PiSCSI/piscsi/hw/ctrl_board_v1p5/ctrl_board.kicad_pcb

## KiCad design hw/ctrl_board_v1p5/ctrl_board.kicad_pcb (2022-03-03, last stored version)

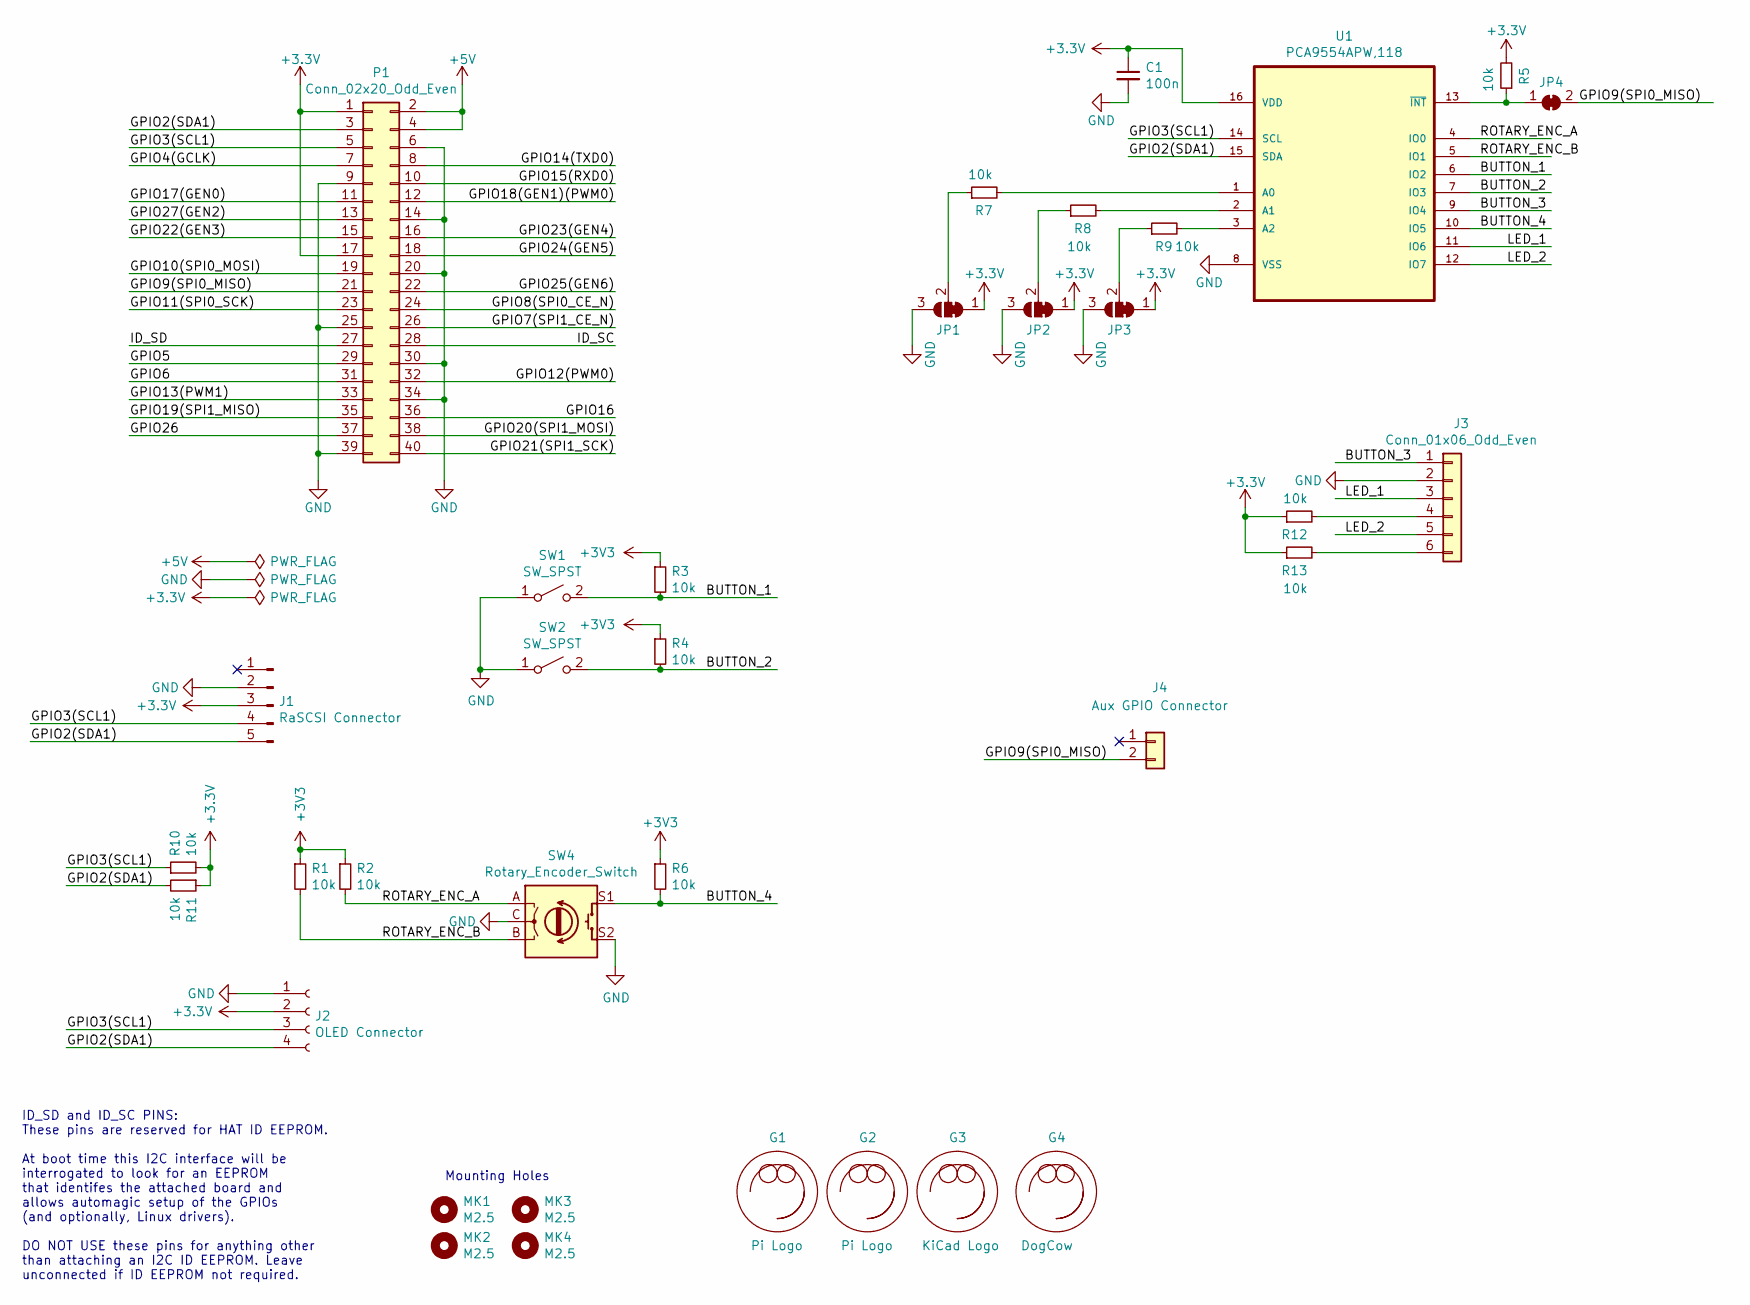
[picture p1: schematic ctrl_board.kicad_sch]

Parts:
C1: 100n; C_0805_2012Metric; LCSC C49678
G1, G2: Pi Logo; pi_logo
G3: KiCad Logo; KiCad-Logo2_5mm_SilkScreen
G4: DogCow; dogcow
J1: RaSCSI Connector; PinHeader_1x05_P2.54mm_Vertical
J2: OLED Connector; 0.9_and_1.3_in_OLED_Footprint
J3: Conn_01x06_Odd_Even; PinHeader_1x06_P2.54mm_Vertical
J4: Aux GPIO Connector; PinHeader_1x02_P2.54mm_Vertical
JP1, JP2, JP3: SolderJumper_3_Bridged12; SolderJumper-3_P1.3mm_Bridged12_RoundedPad1.0x1.5mm
JP4: SolderJumper_2_Open; SolderJumper-2_P1.3mm_Bridged_RoundedPad1.0x1.5mm
MK1, MK2, MK3, MK4: M2.5; MountingHole_2.7mm_M2.5
P1: Conn_02x20_Odd_Even; PinSocket_2x20_P2.54mm_Vertical
R1, R2, R3, R4, R5, R6, R7, R8, R9, R10, R11, R12, R13: 10k; R_0805_2012Metric; LCSC C17414
SW1, SW2: SW_SPST; SW_PUSH_6mm_H5mm; LCSC C110153
SW4: Rotary_Encoder_Switch; RotaryEncoder_Alps_EC11E-Switch_Vertical_H20mm
U1: PCA9554APW,118; TSSOP-16_4.4x5mm_P0.65mm; MPN PCA9554APW,118

Connections:
+5V: P1.2, P1.4
/BUTTON_1: R3.2, SW1.2 (B), U1.6 (IO2)
/BUTTON_2: R4.2, SW2.2 (B), U1.7 (IO3)
/BUTTON_3: J3.1, U1.9 (IO4)
/BUTTON_4: R6.2, SW4.S1, U1.10 (IO5)
/GPIO2(SDA1): J1.5, J2.4, P1.3, R11.2, U1.15 (SDA)
/GPIO3(SCL1): J1.4, J2.3, P1.5, R10.1, U1.14 (SCL)
/GPIO4(GCLK): P1.7
/GPIO5: P1.29
/GPIO6: P1.31
/GPIO7(SPI1_CE_N): P1.26
/GPIO8(SPI0_CE_N): P1.24
/GPIO9(SPI0_MISO): J4.2, JP4.2 (B), P1.21
/GPIO10(SPI0_MOSI): P1.19
/GPIO11(SPI0_SCK): P1.23
/GPIO12(PWM0): P1.32
/GPIO13(PWM1): P1.33
/GPIO14(TXD0): P1.8
/GPIO15(RXD0): P1.10
/GPIO16: P1.36
/GPIO17(GEN0): P1.11
/GPIO18(GEN1)(PWM0): P1.12
/GPIO19(SPI1_MISO): P1.35
/GPIO20(SPI1_MOSI): P1.38
/GPIO21(SPI1_SCK): P1.40
/GPIO22(GEN3): P1.15
/GPIO23(GEN4): P1.16
/GPIO24(GEN5): P1.18
/GPIO25(GEN6): P1.22
/GPIO26: P1.37
/GPIO27(GEN2): P1.13
/ID_SC: P1.28
/ID_SD: P1.27
/LED_1: J3.3, U1.11 (IO6)
/LED_2: J3.5, U1.12 (IO7)
/ROTARY_ENC_A: R2.2, SW4.A, U1.4 (IO0)
/ROTARY_ENC_B: R1.2, SW4.B, U1.5 (IO1)
GND: C1.2, J1.2, J2.1, J3.2, JP1.3 (B), JP2.3 (B), JP3.3 (B), P1.6, P1.9, P1.14, P1.20, P1.25, P1.30, P1.34, P1.39, SW1.1 (A), SW2.1 (A), SW4.C, SW4.S2, U1.8 (VSS)
unnamed: J3.4, R12.2
unnamed: J3.6, R13.2
unnamed: JP1.2 (C), R7.1
unnamed: JP2.2 (C), R8.1
unnamed: JP3.2 (C), R9.1
unnamed: JP4.1 (A), R5.1, U1.13 (~INT)
unnamed: R7.2, U1.1 (A0)
unnamed: R8.2, U1.2 (A1)
unnamed: R9.2, U1.3 (A2)

Notes on the sheet:
ID_SD and ID_SC PINS: These pins are reserved for HAT ID EEPROM. At boot time this I2C interface will be interrogated to look for an EEPROM that identifes the attached board and allows automagic setup of the GPIOs (and optionally, Linux drivers). DO NOT USE these pins for anything other than attach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
Mounting Holes

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
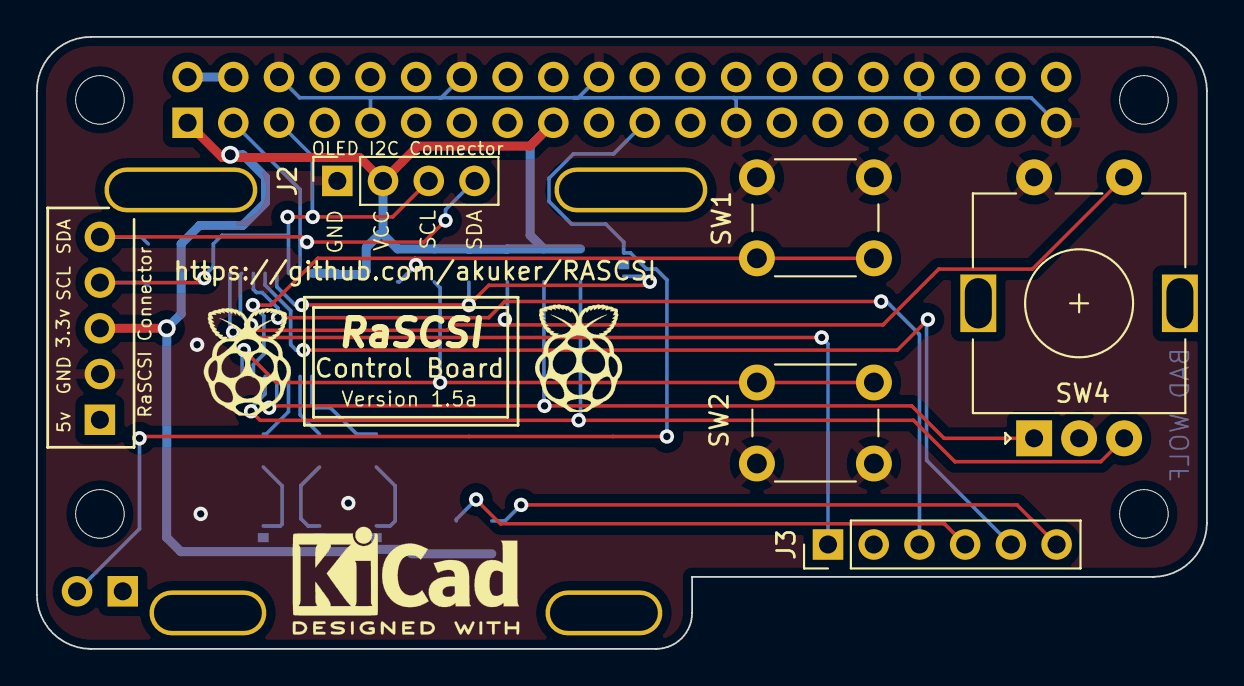
[picture p2: board ctrl_board.kicad_pcb from above]

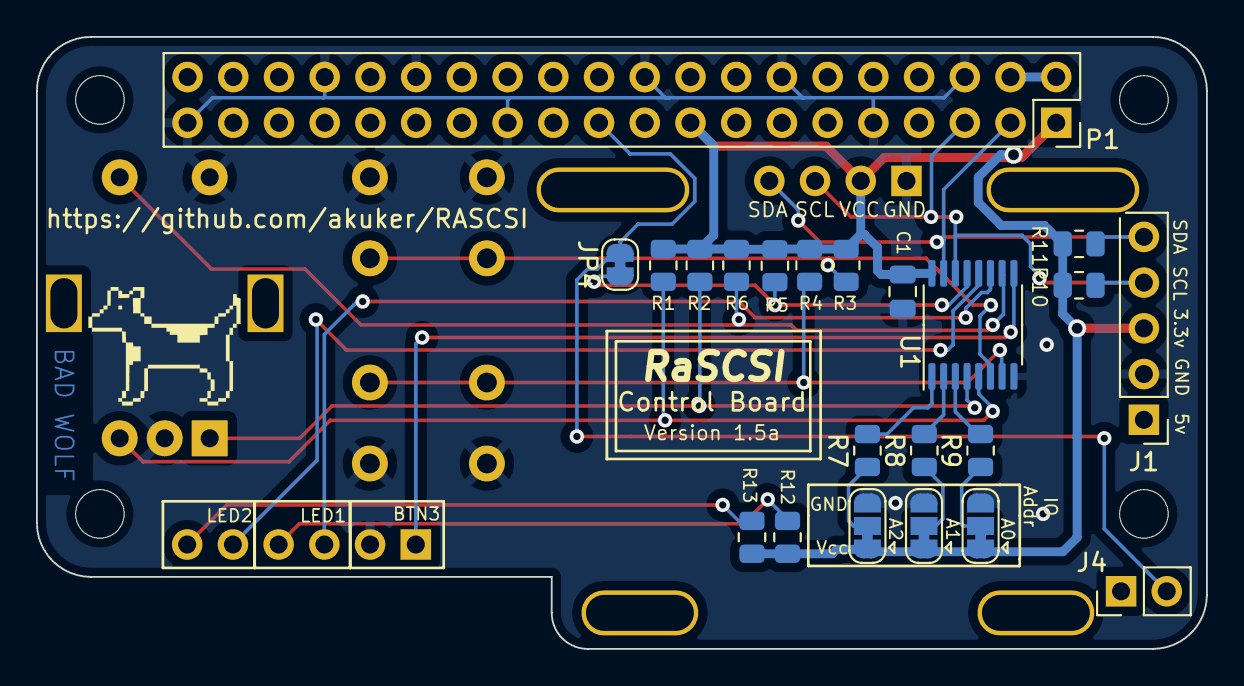
[picture p3: board ctrl_board.kicad_pcb from below]

Board: 2 copper layers, 65.0 x 34.0 mm, 35 parts (26 on the bottom side), 23 nets.
