PiSCSI/piscsi/hw/rascsi_2p5/rascsi_2p5.kicad_pcb

## KiCad design hw/rascsi_2p5/rascsi_2p5.kicad_pcb (2022-03-03, last stored version)

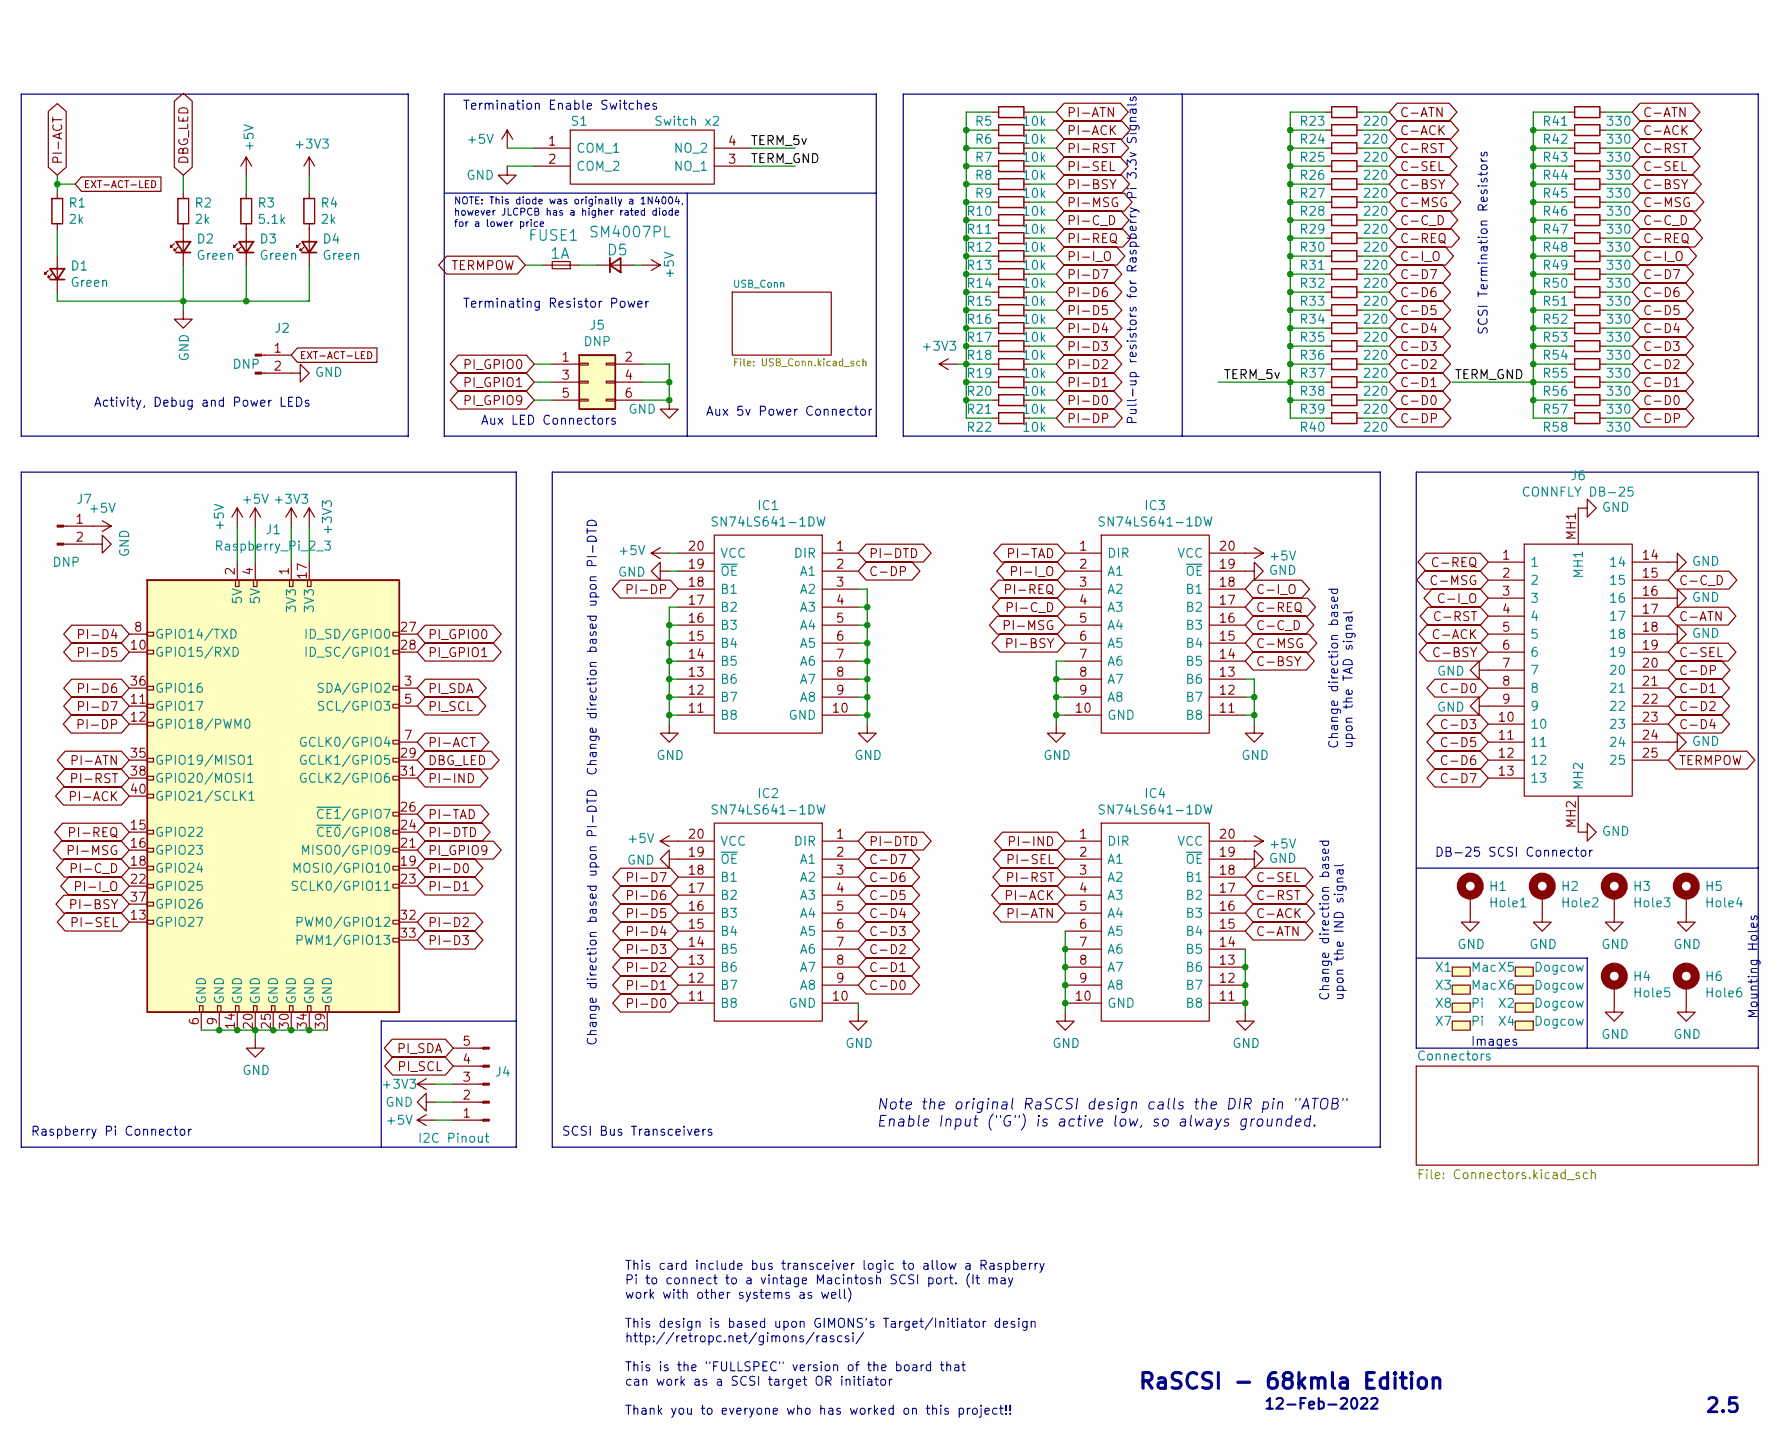
[picture p4: schematic rascsi_2p5.kicad_sch]

Parts:
D1, D2, D3, D4: Green; LED_0805_2012Metric; Manufacturer_Part_Number C2297; LCSC C2297
D5: SM4007PL; D_SOD-123F; Manufacturer_Part_Number SM4007PL; LCSC C64898
FUSE1: 1A; Fuse_1206_3216Metric; Manufacturer_Part_Number 12B1100B; LCSC C182974
H1: Hole1; MountingHole_2.7mm_M2.5_Pad_Via; Manufacturer_Part_Number DNP; LCSC DNP
H2: Hole2; MountingHole_2.7mm_M2.5_Pad_Via; Manufacturer_Part_Number DNP; LCSC DNP
H3: Hole3; MountingHole_2.7mm_M2.5_Pad_Via; Manufacturer_Part_Number DNP; LCSC DNP
H4: Hole5; MountingHole_2.7mm_M2.5_Pad_Via; Manufacturer_Part_Number DNP; LCSC DNP
H5: Hole4; MountingHole_2.7mm_M2.5_Pad_Via; Manufacturer_Part_Number DNP; LCSC DNP
H6: Hole6; MountingHole_2.7mm_M2.5_Pad_Via; Manufacturer_Part_Number DNP; LCSC DNP
IC1, IC2, IC3, IC4: SN74LS641-1DW; SOIC127P1030X265-20N; Manufacturer_Part_Number SN74LS641-1DW; LCSC N/A
J1: Raspberry_Pi_2_3; PinSocket_2x20_P2.54mm_Vertical; Manufacturer_Part_Number C50982; LCSC C50982
J2: DNP; PinHeader_1x02_P2.54mm_Horizontal; Manufacturer_Part_Number DNP; LCSC DNP
J4: I2C Pinout; PinSocket_1x05_P2.54mm_Vertical; Manufacturer_Part_Number C50950; LCSC C50950
J5: DNP; PinHeader_2x03_P2.54mm_Vertical; Manufacturer_Part_Number DNP; LCSC DNP
J6: CONNFLY DB-25; L717SDB25PA4CH4F; Manufacturer_Part_Number DS1037-25FNAKT74-0CC; LCSC C77838
J7: DNP; PinHeader_1x02_P2.54mm_Vertical; Manufacturer_Part_Number DNP; LCSC DNP
R1, R2, R4: 2k; R_0402_1005Metric; Manufacturer_Part_Number 0402WGF2001TCE; LCSC C4109
R3: 5.1k; R_0402_1005Metric; Manufacturer_Part_Number 0402WGF5101TCE; LCSC C25905
R5, R6, R7, R8, R9, R10, R11, R12, R13, R14, R15, R16, R17, R18, R19, R20, R21, R22: 10k; R_0402_1005Metric; Manufacturer_Part_Number 0402WGF1002TCE; LCSC C25744
R23, R24, R25, R26, R27, R28, R29, R30, R31, R32, R33, R34, R35, R36, R37, R38, R39, R40: 220; R_0402_1005Metric; Manufacturer_Part_Number 0402WGF2200TCE; LCSC C25091
R41, R42, R43, R44, R45, R46, R47, R48, R49, R50, R51, R52, R53, R54, R55, R56, R57, R58: 330; R_0402_1005Metric; Manufacturer_Part_Number 0402WGF3300TCE; LCSC C25104
S1: Switch x2; SOIC127P812X230-4N; Manufacturer_Part_Number DSHP02TSGET; LCSC C40735
X1, X3: Mac; mac_happy_small; Manufacturer_Part_Number N/A; LCSC N/A
X2, X4, X5, X6: Dogcow; dogcow; Manufacturer_Part_Number N/A; LCSC N/A
X7: Pi; pi_logo; Manufacturer_Part_Number N/A; LCSC N/A
X8: Pi; scsi_logo; Manufacturer_Part_Number N/A; LCSC N/A

Connections:
+3V3: J1.1 (3V3), J1.17 (3V3), J4.3, R4.1, R5.1, R6.1, R7.1, R8.1, R9.1, R10.1, R11.1, R12.1, R13.1, R14.1, R15.1, R16.1, R17.1, R18.1, R19.1, R20.1, R21.1, R22.1
+5V: D5.2 (A), IC1.20 (VCC), IC2.20 (VCC), IC3.20 (VCC), IC4.20 (VCC), J1.2 (5V), J1.4 (5V), J4.1, J7.1, R3.1, S1.1 (COM_1); also elsewhere on the board
/TERM_5v: R23.1, R24.1, R25.1, R26.1, R27.1, R28.1, R29.1, R30.1, R31.1, R32.1, R33.1, R34.1, R35.1, R36.1, R37.1, R38.1, R39.1, R40.1, S1.4 (NO_2)
/TERM_GND: R41.1, R42.1, R43.1, R44.1, R45.1, R46.1, R47.1, R48.1, R49.1, R50.1, R51.1, R52.1, R53.1, R54.1, R55.1, R56.1, R57.1, R58.1, S1.3 (NO_1)
C-ACK: IC4.16 (B3), J6.5, R24.2, R42.2; also elsewhere on the board
C-ATN: IC4.15 (B4), J6.17, R23.2, R41.2; also elsewhere on the board
C-BSY: IC3.14 (B5), J6.6, R27.2, R45.2; also elsewhere on the board
C-C_D: IC3.16 (B3), J6.15, R29.2, R47.2; also elsewhere on the board
C-D0: IC2.9 (A8), J6.8, R39.2, R57.2; also elsewhere on the board
C-D1: IC2.8 (A7), J6.21, R38.2, R56.2; also elsewhere on the board
C-D2: IC2.7 (A6), J6.22, R37.2, R55.2; also elsewhere on the board
C-D3: IC2.6 (A5), J6.10, R36.2, R54.2; also elsewhere on the board
C-D4: IC2.5 (A4), J6.23, R35.2, R53.2; also elsewhere on the board
C-D5: IC2.4 (A3), J6.11, R34.2, R52.2; also elsewhere on the board
C-D6: IC2.3 (A2), J6.12, R33.2, R51.2; also elsewhere on the board
C-D7: IC2.2 (A1), J6.13, R32.2, R50.2; also elsewhere on the board
C-DP: IC1.2 (A1), J6.20, R40.2, R58.2; also elsewhere on the board
C-I_O: IC3.18 (B1), J6.3, R31.2, R49.2; also elsewhere on the board
C-MSG: IC3.15 (B4), J6.2, R28.2, R46.2; also elsewhere on the board
C-REQ: IC3.17 (B2), J6.1, R30.2, R48.2; also elsewhere on the board
C-RST: IC4.17 (B2), J6.4, R25.2, R43.2; also elsewhere on the board
C-SEL: IC4.18 (B1), J6.19, R26.2, R44.2; also elsewhere on the board
DBG_LED: J1.29 (GCLK1/GPIO5), R2.1
GND: D1.1 (K), D2.1 (K), D3.1 (K), D4.1 (K), H1.1, H2.1, H3.1, H4.1, H5.1, H6.1, IC1.3 (A2), IC1.4 (A3), IC1.5 (A4), IC1.6 (A5), IC1.7 (A6), IC1.8 (A7), IC1.9 (A8), IC1.10 (GND), IC1.11 (B8), IC1.12 (B7), IC1.13 (B6), IC1.14 (B5), IC1.15 (B4), IC1.16 (B3), IC1.17 (B2), IC1.19 (~OE), IC2.10 (GND), IC2.19 (~OE), IC3.7 (A6), IC3.8 (A7), IC3.9 (A8), IC3.10 (GND), IC3.11 (B8), IC3.12 (B7), IC3.13 (B6), IC3.19 (~OE), IC4.6 (A5), IC4.7 (A6), IC4.8 (A7), IC4.9 (A8), IC4.10 (GND), IC4.11 (B8), IC4.12 (B7), IC4.13 (B6), IC4.14 (B5), IC4.19 (~OE), J1.6 (GND), J1.9 (GND), J1.14 (GND), J1.20 (GND), J1.25 (GND), J1.30 (GND), J1.34 (GND), J1.39 (GND), J2.2, J4.2, J5.2, J5.4, J5.6, J6.7, J6.9, J6.14, J6.16, J6.18, J6.24, J6.MH1, J6.MH2, J7.2, S1.2 (COM_2); also elsewhere on the board
unnamed: D1.2 (A), R1.2
unnamed: D2.2 (A), R2.2
unnamed: D3.2 (A), R3.2
unnamed: D4.2 (A), R4.2
unnamed: D5.1 (K), FUSE1.1
PB_LED_Pin: J1.7 (GCLK0/GPIO4), J2.1, R1.1; also elsewhere on the board
PI-ACK: IC4.4 (A3), J1.40 (GPIO21/SCLK1), R6.2
PI-ATN: IC4.5 (A4), J1.35 (GPIO19/MISO1), R5.2
PI-BSY: IC3.6 (A5), J1.37 (GPIO26), R9.2
PI-C_D: IC3.4 (A3), J1.18 (GPIO24), R11.2
PI-D0: IC2.11 (B8), J1.19 (MOSI0/GPIO10), R21.2
PI-D1: IC2.12 (B7), J1.23 (SCLK0/GPIO11), R20.2
PI-D2: IC2.13 (B6), J1.32 (PWM0/GPIO12), R19.2
PI-D3: IC2.14 (B5), J1.33 (PWM1/GPIO13), R18.2
PI-D4: IC2.15 (B4), J1.8 (GPIO14/TXD), R17.2
PI-D5: IC2.16 (B3), J1.10 (GPIO15/RXD), R16.2
PI-D6: IC2.17 (B2), J1.36 (GPIO16), R15.2
PI-D7: IC2.18 (B1), J1.11 (GPIO17), R14.2
PI-DP: IC1.18 (B1), J1.12 (GPIO18/PWM0), R22.2
PI-DTD: IC1.1 (DIR), IC2.1 (DIR), J1.24 (~CE0/GPIO8)
PI-IND: IC4.1 (DIR), J1.31 (GCLK2/GPIO6)
PI-I_O: IC3.2 (A1), J1.22 (GPIO25), R13.2
PI-MSG: IC3.5 (A4), J1.16 (GPIO23), R10.2
PI-REQ: IC3.3 (A2), J1.15 (GPIO22), R12.2
PI-RST: IC4.3 (A2), J1.38 (GPIO20/MOSI1), R7.2
PI-SEL: IC4.2 (A1), J1.13 (GPIO27), R8.2
PI-TAD: IC3.1 (DIR), J1.26 (~CE1/GPIO7)
PI_GPIO0: J1.27 (ID_SD/GPIO0), J5.1
PI_GPIO1: J1.28 (ID_SC/GPIO1), J5.3
PI_GPIO9: J1.21 (MISO0/GPIO9), J5.5
PI_SCL: J1.5 (SCL/GPIO3), J4.4
PI_SDA: J1.3 (SDA/GPIO2), J4.5
TERMPOW: FUSE1.2, J6.25; also elsewhere on the board

Notes on the sheet:
Images
RaSCSI - 68kmla Edition
2.5
Raspberry Pi Connector
Change direction based upon the TAD signal
Terminating Resistor Power
Mounting Holes
12-Feb-2022
DB-25 SCSI Connector
SCSI Termination Resistors
Pull-up resistors for Raspberry Pi 3.3v Signals
Change direction based upon the IND signal
NOTE: This diode was originally a 1N4004, however JLCPCB has a higher rated diode for a lower price
Change direction based upon PI-DTD
Note the original RaSCSI design calls the DIR pin "ATOB" Enable Input ("G") is active low, so always grounded.
Activity, Debug and Power LEDs
Termination Enable Switches
This card include bus transceiver logic to allow a Raspberry Pi to connect to a vintage Macintosh SCSI port. (It may work with other systems as well) This design is based upon GIMONS's Target/Initiator design http://retropc.net/gimons/rascsi/ This is the "FULLSPEC" version of the board that can wor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
Aux 5v Power Connector
SCSI Bus Transceivers
Aux LED Connectors

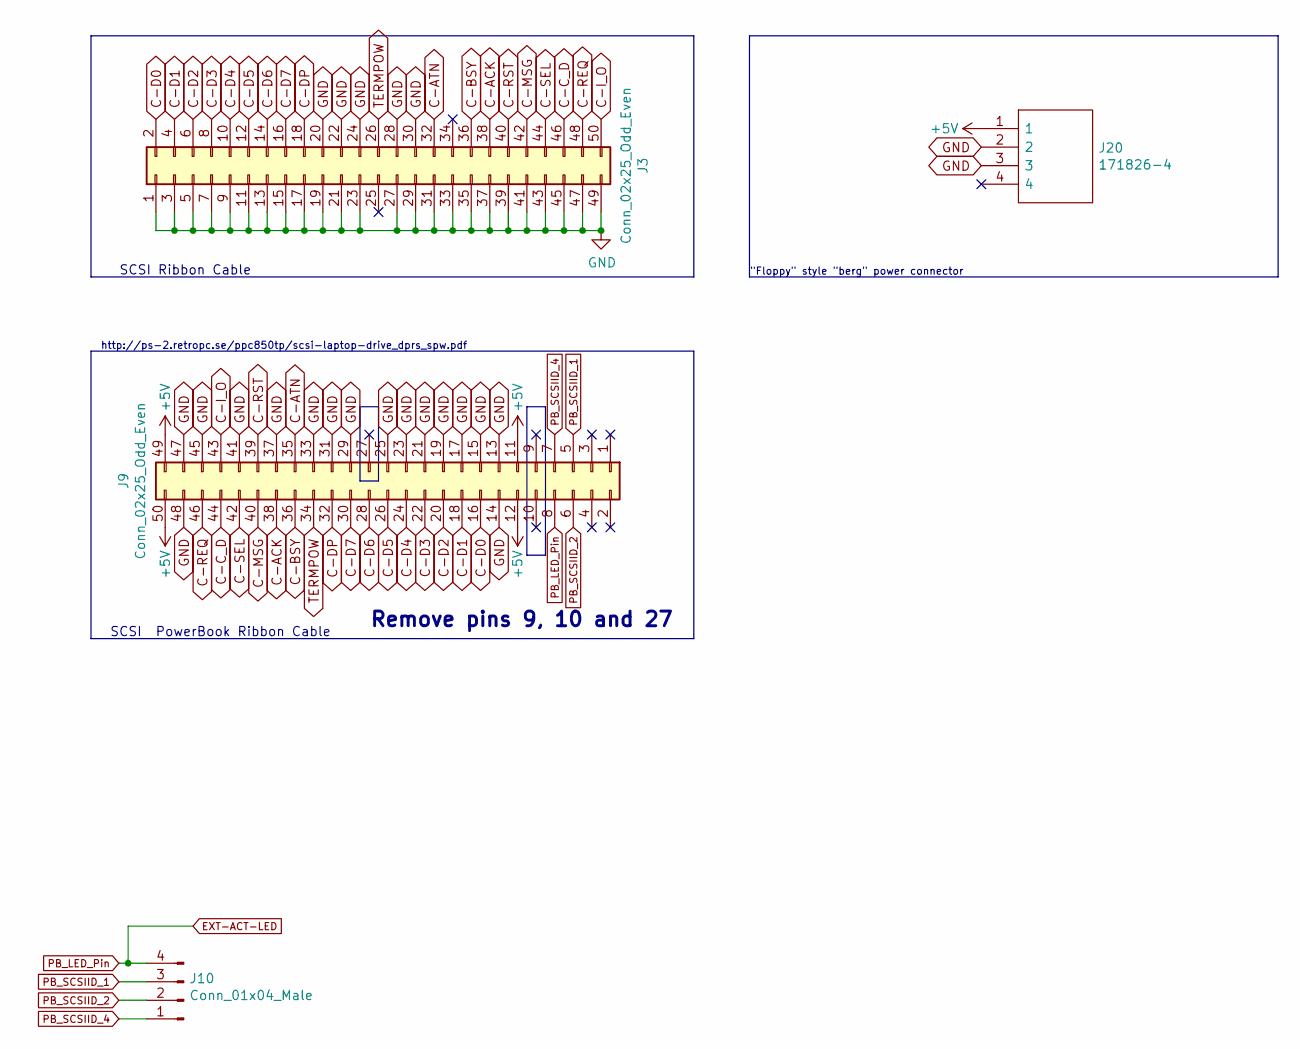
[picture p5: schematic Connectors.kicad_sch]

Parts:
J3: Conn_02x25_Odd_Even; PinHeader_2x25_P2.54mm_Vertical; Manufacturer_Part_Number C30006; LCSC C30006
J9: Conn_02x25_Odd_Even; PinHeader_2x25_P2.00mm_Horizontal; Manufacturer_Part_Number C3407; LCSC C3407
J10: Conn_01x04_Male; PinHeader_1x04_P2.00mm_Vertical
J20: 171826-4; SHDRRA4W69P0X250_1X4_1000X1350X670P; Mouser Part Number 571-1718264

Connections:
+5V: J9.11, J9.12, J9.49, J9.50, J20.1; also elsewhere on the board
C-ACK: J3.38, J9.38; also elsewhere on the board
C-ATN: J3.32, J9.35; also elsewhere on the board
C-BSY: J3.36, J9.36; also elsewhere on the board
C-C_D: J3.46, J9.44; also elsewhere on the board
C-D0: J3.2, J9.16; also elsewhere on the board
C-D1: J3.4, J9.18; also elsewhere on the board
C-D2: J3.6, J9.20; also elsewhere on the board
C-D3: J3.8, J9.22; also elsewhere on the board
C-D4: J3.10, J9.24; also elsewhere on the board
C-D5: J3.12, J9.26; also elsewhere on the board
C-D6: J3.14, J9.28; also elsewhere on the board
C-D7: J3.16, J9.30; also elsewhere on the board
C-DP: J3.18, J9.32; also elsewhere on the board
C-I_O: J3.50, J9.43; also elsewhere on the board
C-MSG: J3.42, J9.40; also elsewhere on the board
C-REQ: J3.48, J9.46; also elsewhere on the board
C-RST: J3.40, J9.39; also elsewhere on the board
C-SEL: J3.44, J9.42; also elsewhere on the board
GND: J3.1, J3.3, J3.5, J3.7, J3.9, J3.11, J3.13, J3.15, J3.17, J3.19, J3.20, J3.21, J3.22, J3.23, J3.24, J3.27, J3.28, J3.29, J3.30, J3.31, J3.33, J3.35, J3.37, J3.39, J3.41, J3.43, J3.45, J3.47, J3.49, J9.13, J9.14, J9.15, J9.17, J9.19, J9.21, J9.23, J9.25, J9.29, J9.31, J9.33, J9.37, J9.41, J9.45, J9.47, J9.48, J20.2, J20.3; also elsewhere on the board
PB_LED_Pin: J9.8, J10.4; also elsewhere on the board
PB_SCSIID_1: J9.5, J10.3
PB_SCSIID_2: J9.6, J10.2
PB_SCSIID_4: J9.7, J10.1
TERMPOW: J3.26, J9.34; also elsewhere on the board

Notes on the sheet:
Remove pins 9, 10 and 27
SCSI Ribbon Cable
"Floppy" style "berg" power connector
http://ps-2.retropc.se/ppc850tp/scsi-laptop-drive_dprs_spw.pdf
SCSI PowerBook Ribbon Cable

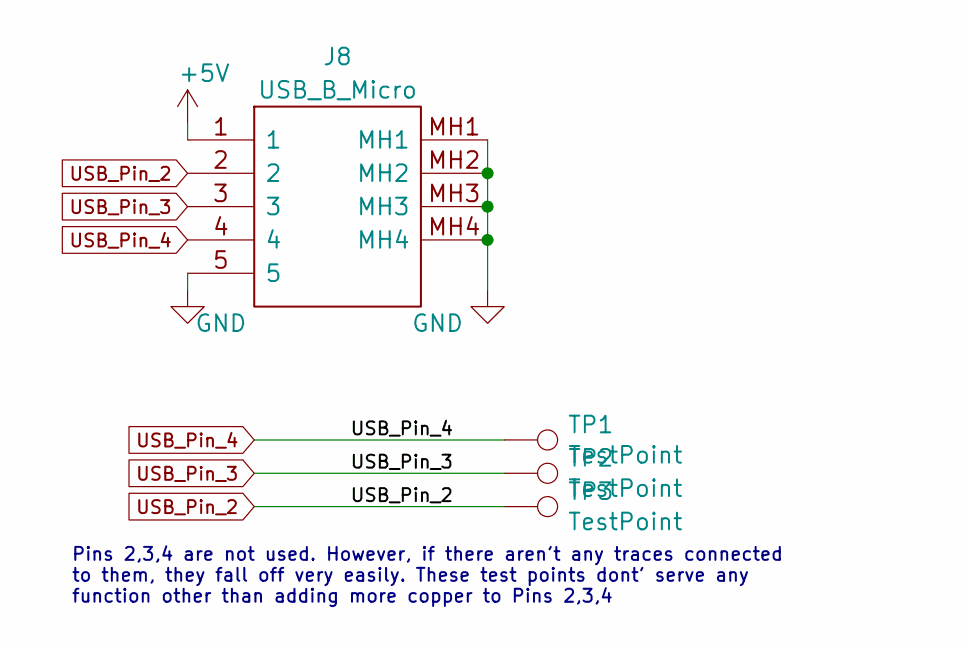
[picture p6: schematic USB_Conn.kicad_sch]

Parts:
J8: USB_B_Micro; U254051N4BH806; Manufacturer_Part_Number U254-051N-4BH806; LCSC C319170
TP1, TP2, TP3: TestPoint; TestPoint_Pad_D1.0mm; Manufacturer_Part_Number N/A; LCSC N/A

Connections:
+5V: J8.1; also elsewhere on the board
GND: J8.5, J8.MH1, J8.MH2, J8.MH3, J8.MH4; also elsewhere on the board
USB_Pin_2: J8.2, TP3.1
USB_Pin_3: J8.3, TP2.1
USB_Pin_4: J8.4, TP1.1

Notes on the sheet:
Pins 2,3,4 are not used. However, if there aren't any traces connected to them, they fall off very easily. These test points dont' serve any function other than adding more copper to Pins 2,3,4

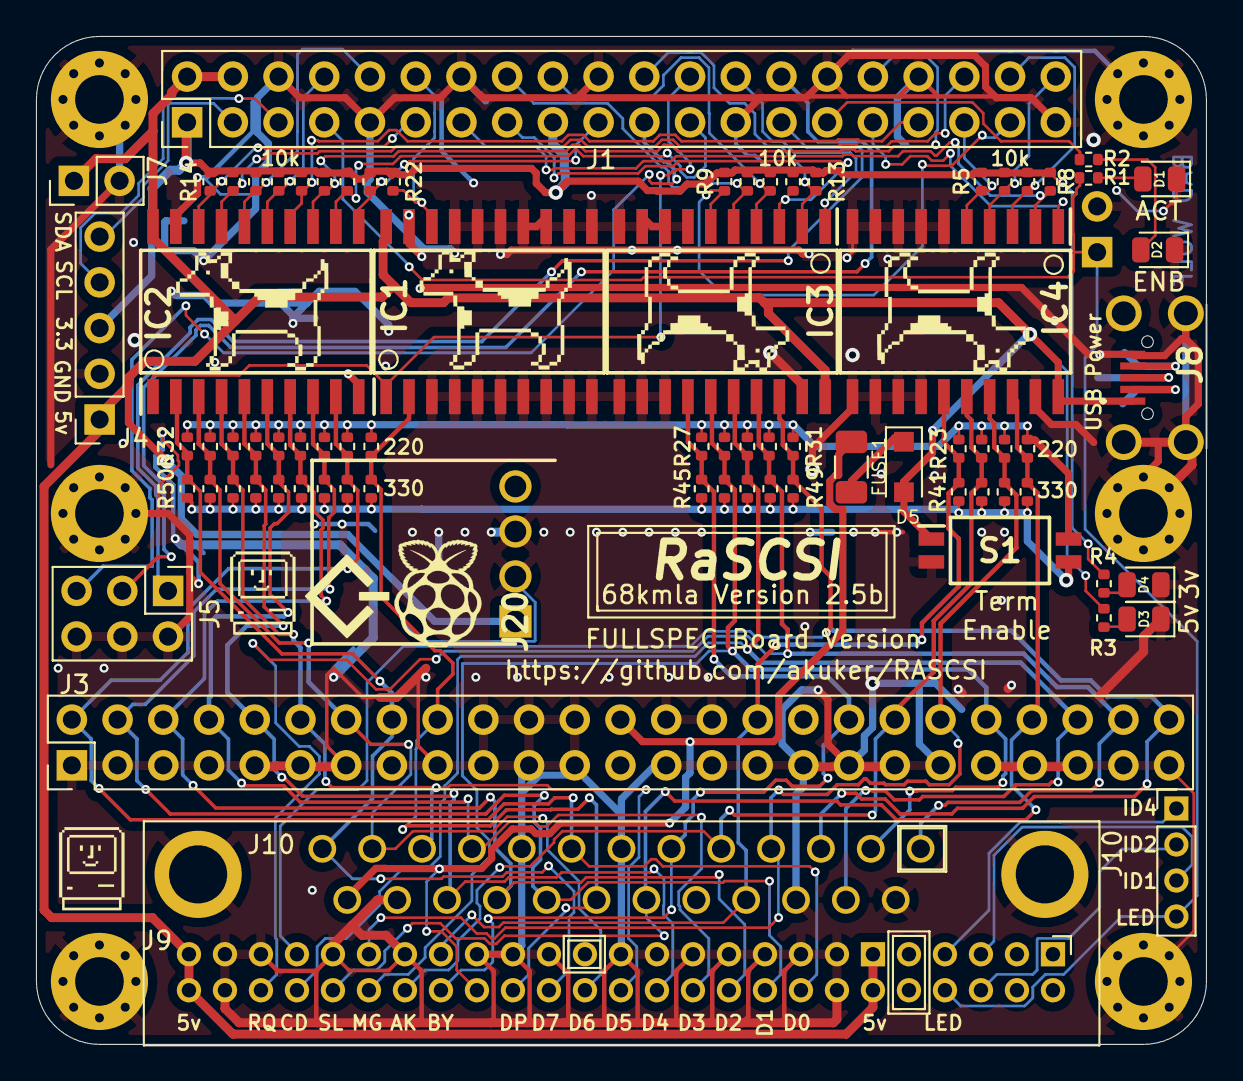
[picture p7: board rascsi_2p5.kicad_pcb from above]

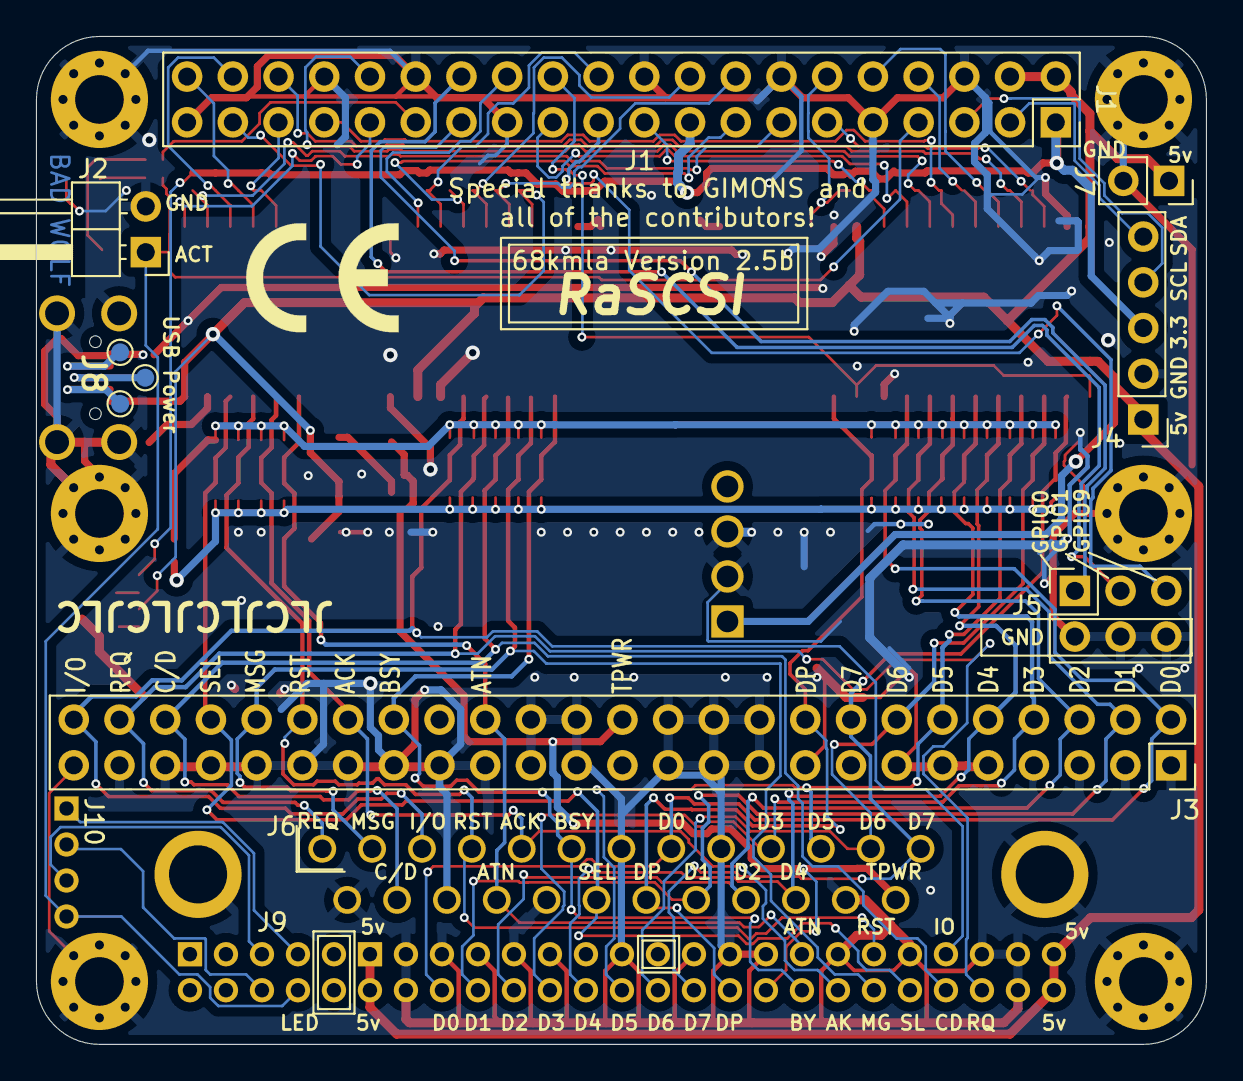
[picture p8: board rascsi_2p5.kicad_pcb from below]

Board: 2 copper layers, 65.0 x 56.0 mm, 97 parts (6 on the bottom side), 63 nets.
