PiSCSI/piscsi/hw/rascsi_tester/rascsi_tester.kicad_pcb

## KiCad design hw/rascsi_tester/rascsi_tester.kicad_pcb (2020-08-23, last stored version)

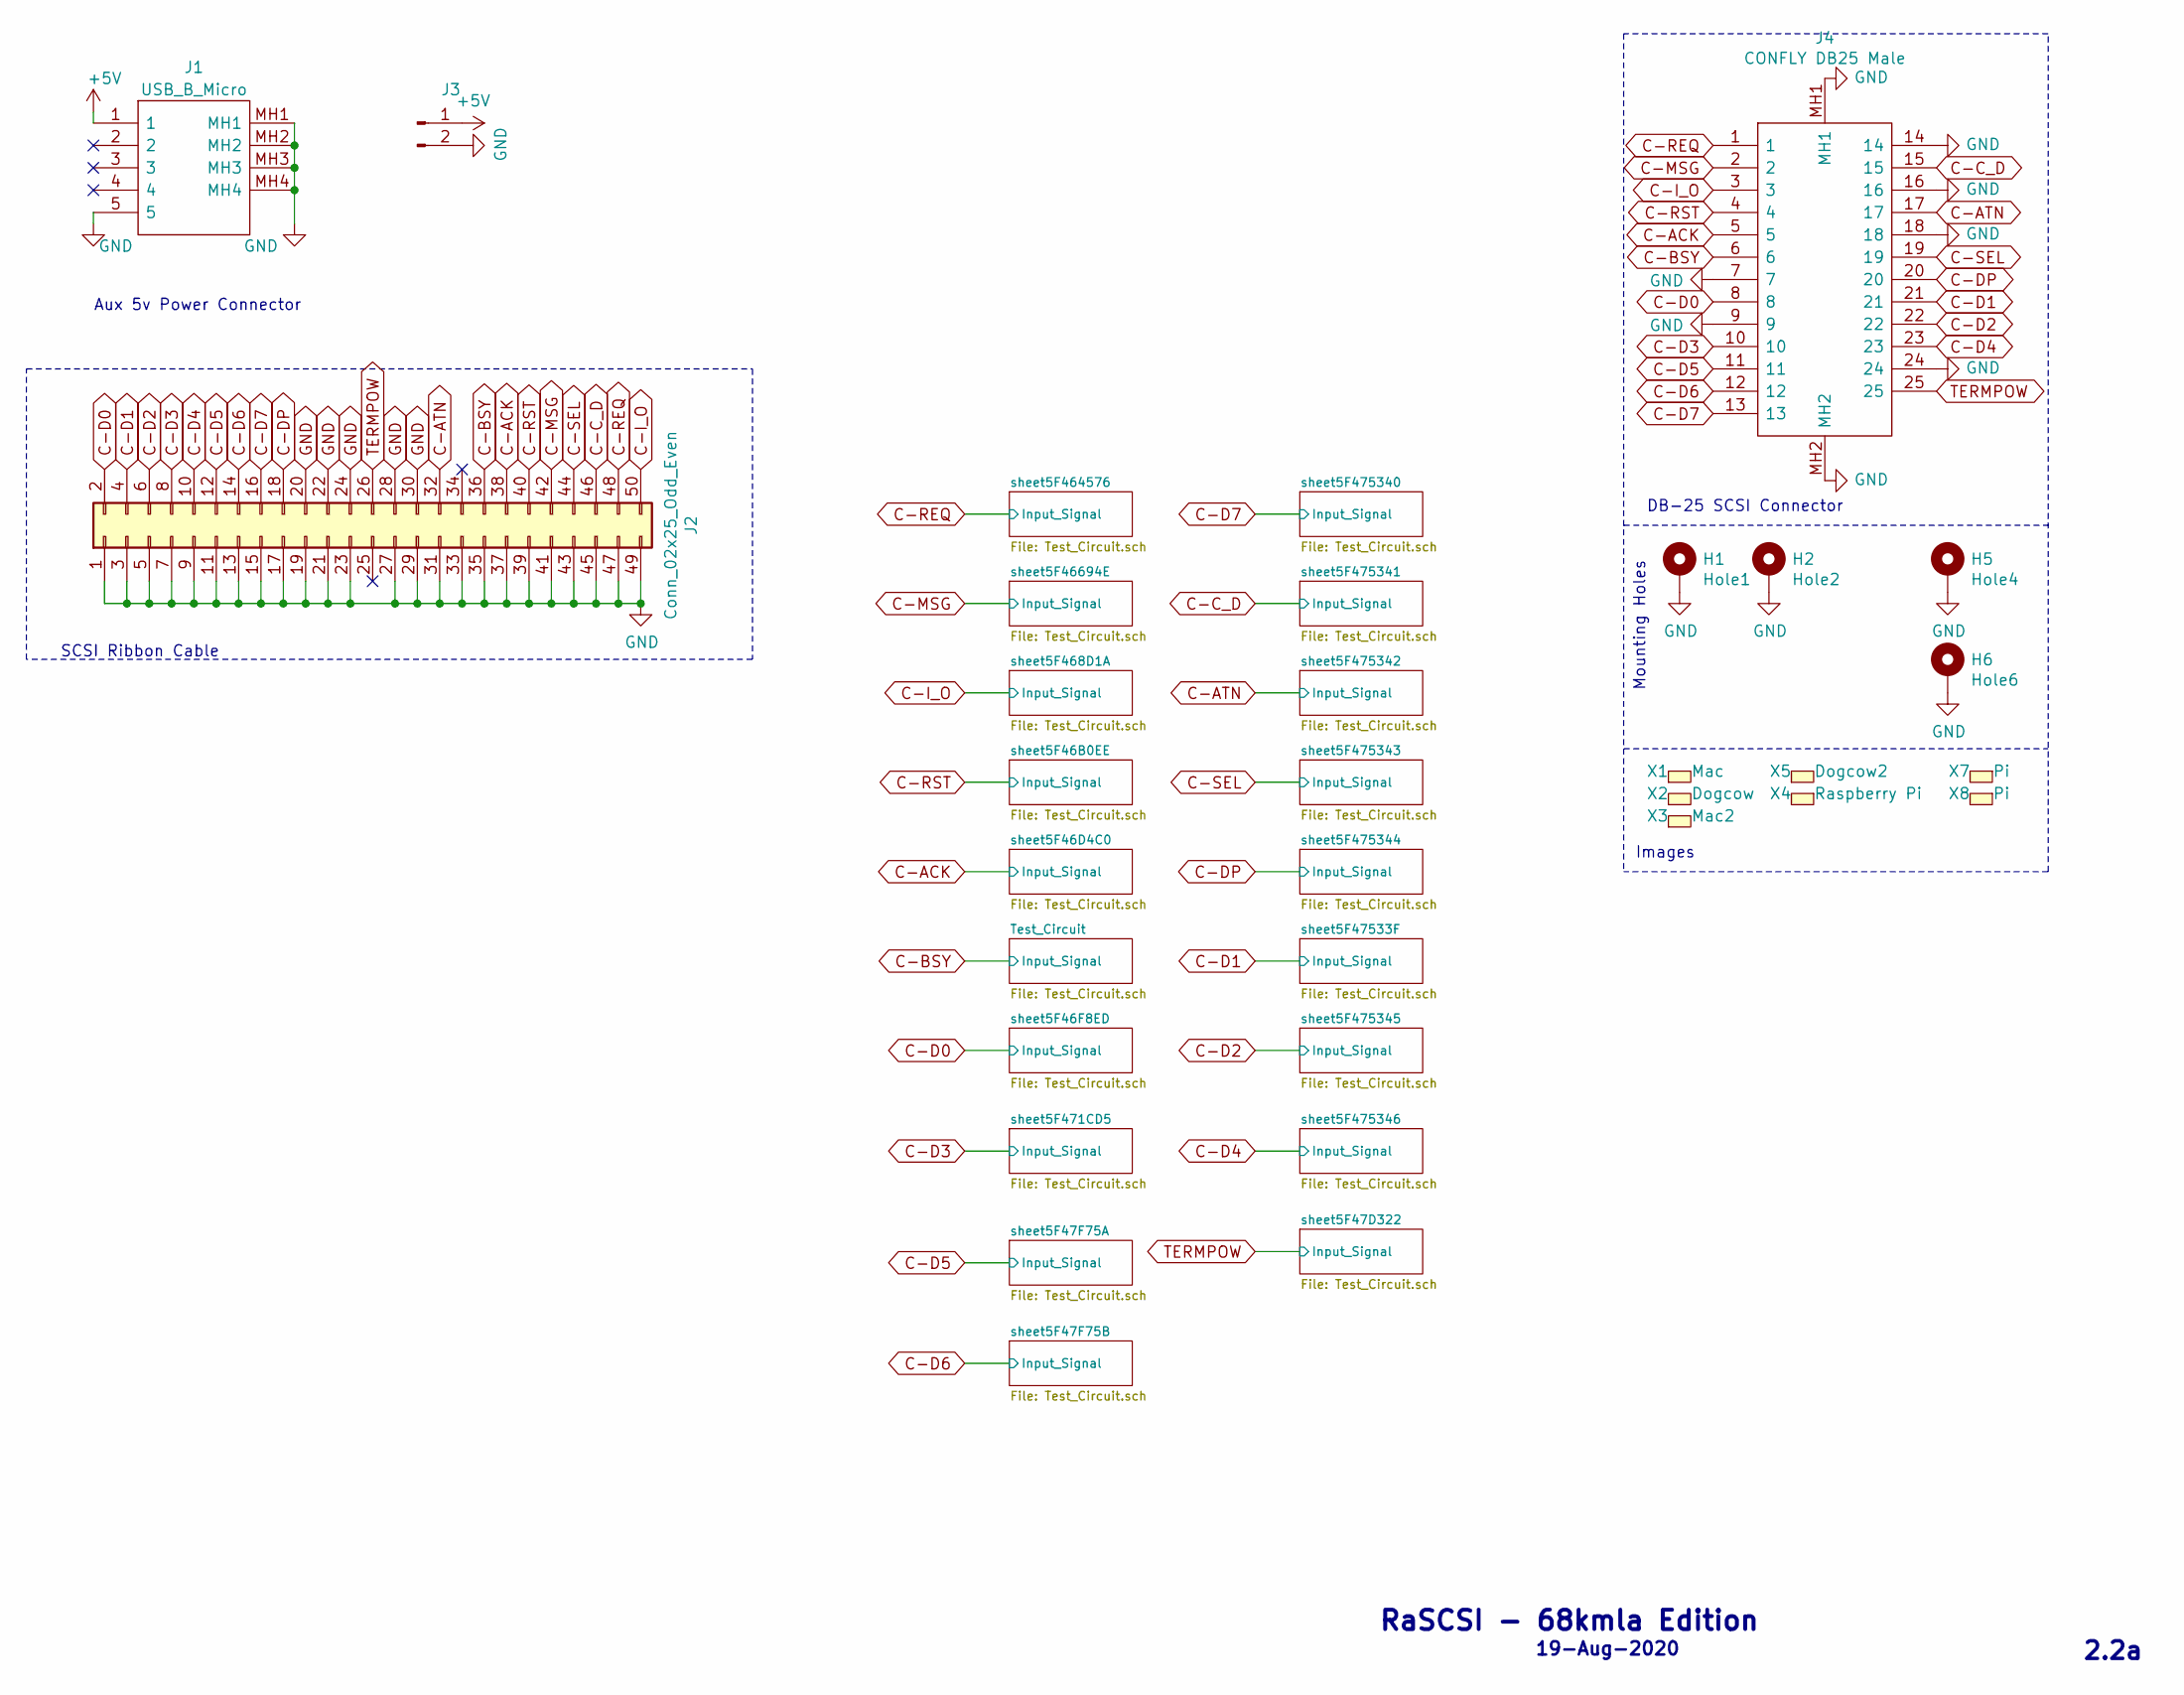
[picture p13: schematic rascsi_tester.sch]

Parts:
H1: Hole1; MountingHole_2.7mm_M2.5_Pad_Via
H2: Hole2; MountingHole_2.7mm_M2.5_Pad_Via
H5: Hole4; MountingHole_2.7mm_M2.5_Pad_Via
H6: Hole6; MountingHole_2.7mm_M2.5_Pad_Via
J1: USB_B_Micro; U254051N4BH806; LCSC C319170
J2: Conn_02x25_Odd_Even; PinHeader_2x25_P2.54mm_Vertical; LCSC C40024
J3: Conn_01x02_Male; PinHeader_1x02_P2.54mm_Vertical
J4: CONFLY DB25 Male; L717SDB25PA4CH4F; Mouser Part Number 523-L717SDB25PA4CH4F
X1: Mac; mac_happy_small
X2: Dogcow; dogcow
X3: Mac2; mac_happy_small
X4: Raspberry Pi; pi_logo
X5: Dogcow2; dogcow
X7: Pi; pi_logo
X8: Pi; scsi_logo

Connections:
+5V: J1.1, J3.1; also elsewhere on the board
C-ACK: J2.38, J4.5; also elsewhere on the board
C-ATN: J2.32, J4.17; also elsewhere on the board
C-BSY: J2.36, J4.6; also elsewhere on the board
C-C_D: J2.46, J4.15; also elsewhere on the board
C-D0: J2.2, J4.8; also elsewhere on the board
C-D1: J2.4, J4.21; also elsewhere on the board
C-D2: J2.6, J4.22; also elsewhere on the board
C-D3: J2.8, J4.10; also elsewhere on the board
C-D4: J2.10, J4.23; also elsewhere on the board
C-D5: J2.12, J4.11; also elsewhere on the board
C-D6: J2.14, J4.12; also elsewhere on the board
C-D7: J2.16, J4.13; also elsewhere on the board
C-DP: J2.18, J4.20; also elsewhere on the board
C-I_O: J2.50, J4.3; also elsewhere on the board
C-MSG: J2.42, J4.2; also elsewhere on the board
C-REQ: J2.48, J4.1; also elsewhere on the board
C-RST: J2.40, J4.4; also elsewhere on the board
C-SEL: J2.44, J4.19; also elsewhere on the board
GND: H1.1, H2.1, H5.1, H6.1, J1.5, J1.MH1, J1.MH2, J1.MH3, J1.MH4, J2.1, J2.3, J2.5, J2.7, J2.9, J2.11, J2.13, J2.15, J2.17, J2.19, J2.20, J2.21, J2.22, J2.23, J2.24, J2.27, J2.28, J2.29, J2.30, J2.31, J2.33, J2.35, J2.37, J2.39, J2.41, J2.43, J2.45, J2.47, J2.49, J3.2, J4.7, J4.9, J4.14, J4.16, J4.18, J4.24, J4.MH1, J4.MH2; also elsewhere on the board
TERMPOW: J2.26, J4.25; also elsewhere on the board

Notes on the sheet:
DB-25 SCSI Connector
SCSI Ribbon Cable
Images
Mounting Holes
RaSCSI - 68kmla Edition
2.2a
19-Aug-2020
Aux 5v Power Connector

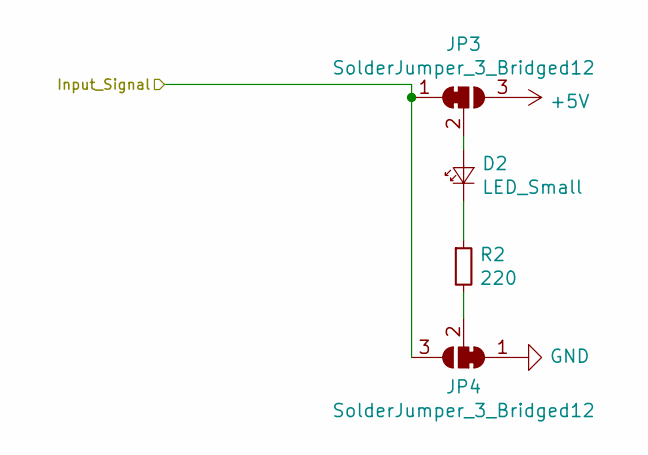
[picture p14: schematic Test_Circuit.sch]

Parts:
D1: LED_Small; LED_0805_2012Metric; LCSC C125090
JP1, JP2: SolderJumper_3_Bridged12; SolderJumper-3_P1.3mm_Bridged12_Pad1.0x1.5mm
R1: 220; R_0805_2012Metric; LCSC C17557

Connections:
+5V: JP1.3 (B); also elsewhere on the board
C-BSY: JP1.1 (A), JP2.3 (B); also elsewhere on the board
GND: JP2.1 (A); also elsewhere on the board
unnamed: D1.1 (K), R1.1
unnamed: D1.2 (A), JP1.2 (C)
unnamed: JP2.2 (C), R1.2

Parts of its further copies:
D2, D3, D4, D5, D6, D7, D8, D9, D10, D11, D12, D13, D14, D15, D16, D17, D18, D19: LED_Small; LED_0805_2012Metric; LCSC C125090
JP3, JP4, JP5, JP6, JP7, JP8, JP9, JP10, JP11, JP12, JP13, JP14, JP15, JP16, JP17, JP18, JP19, JP20, JP21, JP22, JP23, JP24, JP25, JP26, JP27, JP28, JP29, JP30, JP31, JP32, JP33, JP34, JP35, JP36, JP37, JP38: SolderJumper_3_Bridged12; SolderJumper-3_P1.3mm_Bridged12_Pad1.0x1.5mm
R2, R3, R4, R5, R6, R7, R8, R9, R10, R11, R12, R13, R14, R15, R16, R17, R18, R19: 220; R_0805_2012Metric; LCSC C17557

Connections of its further copies:
+5V: JP3.3 (B), JP5.3 (B), JP7.3 (B), JP9.3 (B), JP11.3 (B), JP13.3 (B), JP15.3 (B), JP17.3 (B), JP19.3 (B), JP21.3 (B), JP23.3 (B), JP25.3 (B), JP27.3 (B), JP29.3 (B), JP31.3 (B), JP33.3 (B), JP35.3 (B), JP37.3 (B); also elsewhere on the board
C-ACK: JP11.1 (A), JP12.3 (B); also elsewhere on the board
C-ATN: JP23.1 (A), JP24.3 (B); also elsewhere on the board
C-C_D: JP21.1 (A), JP22.3 (B); also elsewhere on the board
C-D0: JP13.1 (A), JP14.3 (B); also elsewhere on the board
C-D1: JP17.1 (A), JP18.3 (B); also elsewhere on the board
C-D2: JP29.1 (A), JP30.3 (B); also elsewhere on the board
C-D3: JP15.1 (A), JP16.3 (B); also elsewhere on the board
C-D4: JP31.1 (A), JP32.3 (B); also elsewhere on the board
C-D5: JP35.1 (A), JP36.3 (B); also elsewhere on the board
C-D6: JP37.1 (A), JP38.3 (B); also elsewhere on the board
C-D7: JP19.1 (A), JP20.3 (B); also elsewhere on the board
C-DP: JP27.1 (A), JP28.3 (B); also elsewhere on the board
C-I_O: JP7.1 (A), JP8.3 (B); also elsewhere on the board
C-MSG: JP5.1 (A), JP6.3 (B); also elsewhere on the board
C-REQ: JP3.1 (A), JP4.3 (B); also elsewhere on the board
C-RST: JP9.1 (A), JP10.3 (B); also elsewhere on the board
C-SEL: JP25.1 (A), JP26.3 (B); also elsewhere on the board
GND: JP4.1 (A), JP6.1 (A), JP8.1 (A), JP10.1 (A), JP12.1 (A), JP14.1 (A), JP16.1 (A), JP18.1 (A), JP20.1 (A), JP22.1 (A), JP24.1 (A), JP26.1 (A), JP28.1 (A), JP30.1 (A), JP32.1 (A), JP34.1 (A), JP36.1 (A), JP38.1 (A); also elsewhere on the board
unnamed: D2.1 (K), R2.1
unnamed: D2.2 (A), JP3.2 (C)
unnamed: D3.1 (K), R3.1
unnamed: D3.2 (A), JP5.2 (C)
unnamed: D4.1 (K), R4.1
unnamed: D4.2 (A), JP7.2 (C)
unnamed: D5.1 (K), R5.1
unnamed: D5.2 (A), JP9.2 (C)
unnamed: D6.1 (K), R6.1
unnamed: D6.2 (A), JP11.2 (C)
unnamed: D7.1 (K), R7.1
unnamed: D7.2 (A), JP13.2 (C)
unnamed: D8.1 (K), R8.1
unnamed: D8.2 (A), JP15.2 (C)
unnamed: D9.1 (K), R9.1
unnamed: D9.2 (A), JP17.2 (C)
unnamed: D10.1 (K), R10.1
unnamed: D10.2 (A), JP19.2 (C)
unnamed: D11.1 (K), R11.1
unnamed: D11.2 (A), JP21.2 (C)
unnamed: D12.1 (K), R12.1
unnamed: D12.2 (A), JP23.2 (C)
unnamed: D13.1 (K), R13.1
unnamed: D13.2 (A), JP25.2 (C)
unnamed: D14.1 (K), R14.1
unnamed: D14.2 (A), JP27.2 (C)
unnamed: D15.1 (K), R15.1
unnamed: D15.2 (A), JP29.2 (C)
unnamed: D16.1 (K), R16.1
unnamed: D16.2 (A), JP31.2 (C)
unnamed: D17.1 (K), R17.1
unnamed: D17.2 (A), JP33.2 (C)
unnamed: D18.1 (K), R18.1
unnamed: D18.2 (A), JP35.2 (C)
unnamed: D19.1 (K), R19.1
unnamed: D19.2 (A), JP37.2 (C)
unnamed: JP4.2 (C), R2.2
unnamed: JP6.2 (C), R3.2
unnamed: JP8.2 (C), R4.2
unnamed: JP10.2 (C), R5.2
unnamed: JP12.2 (C), R6.2
unnamed: JP14.2 (C), R7.2
unnamed: JP16.2 (C), R8.2
unnamed: JP18.2 (C), R9.2
unnamed: JP20.2 (C), R10.2
unnamed: JP22.2 (C), R11.2
unnamed: JP24.2 (C), R12.2
unnamed: JP26.2 (C), R13.2
unnamed: JP28.2 (C), R14.2
unnamed: JP30.2 (C), R15.2
unnamed: JP32.2 (C), R16.2
unnamed: JP34.2 (C), R17.2
unnamed: JP36.2 (C), R18.2
unnamed: JP38.2 (C), R19.2
TERMPOW: JP33.1 (A), JP34.3 (B); also elsewhere on the board

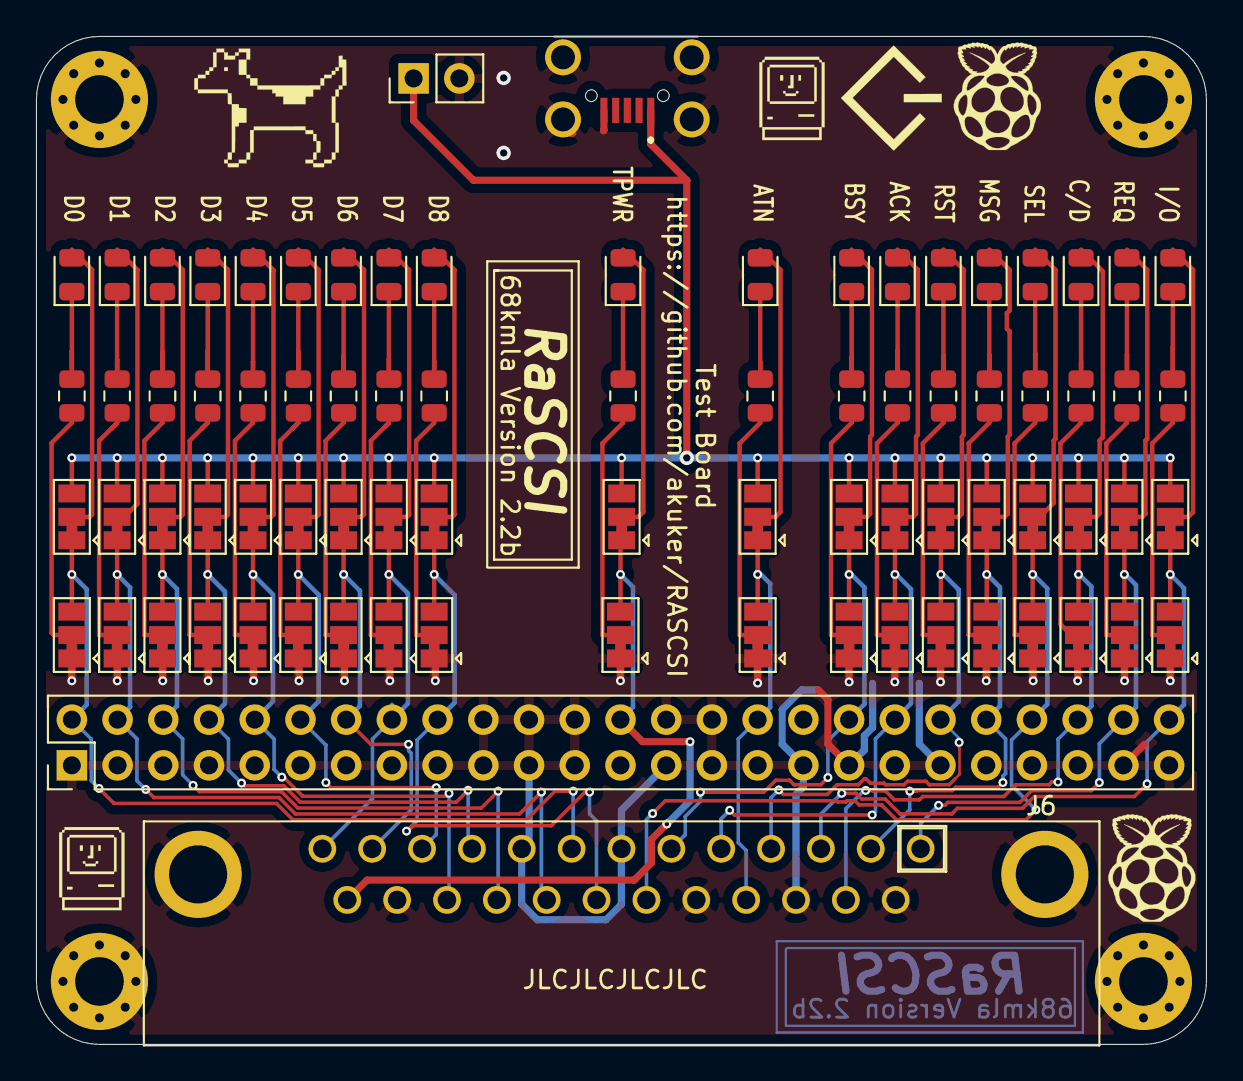
[picture p15: board rascsi_tester.kicad_pcb from above]

Board: 2 copper layers, 65.0 x 56.0 mm, 91 parts (0 on the bottom side), 78 nets.
