PiSCSI/piscsi/hw/rascsi_2p1/rascsi_2p1.kicad_pcb

## KiCad design hw/rascsi_2p1/rascsi_2p1.kicad_pcb (2020-08-03, last stored version)

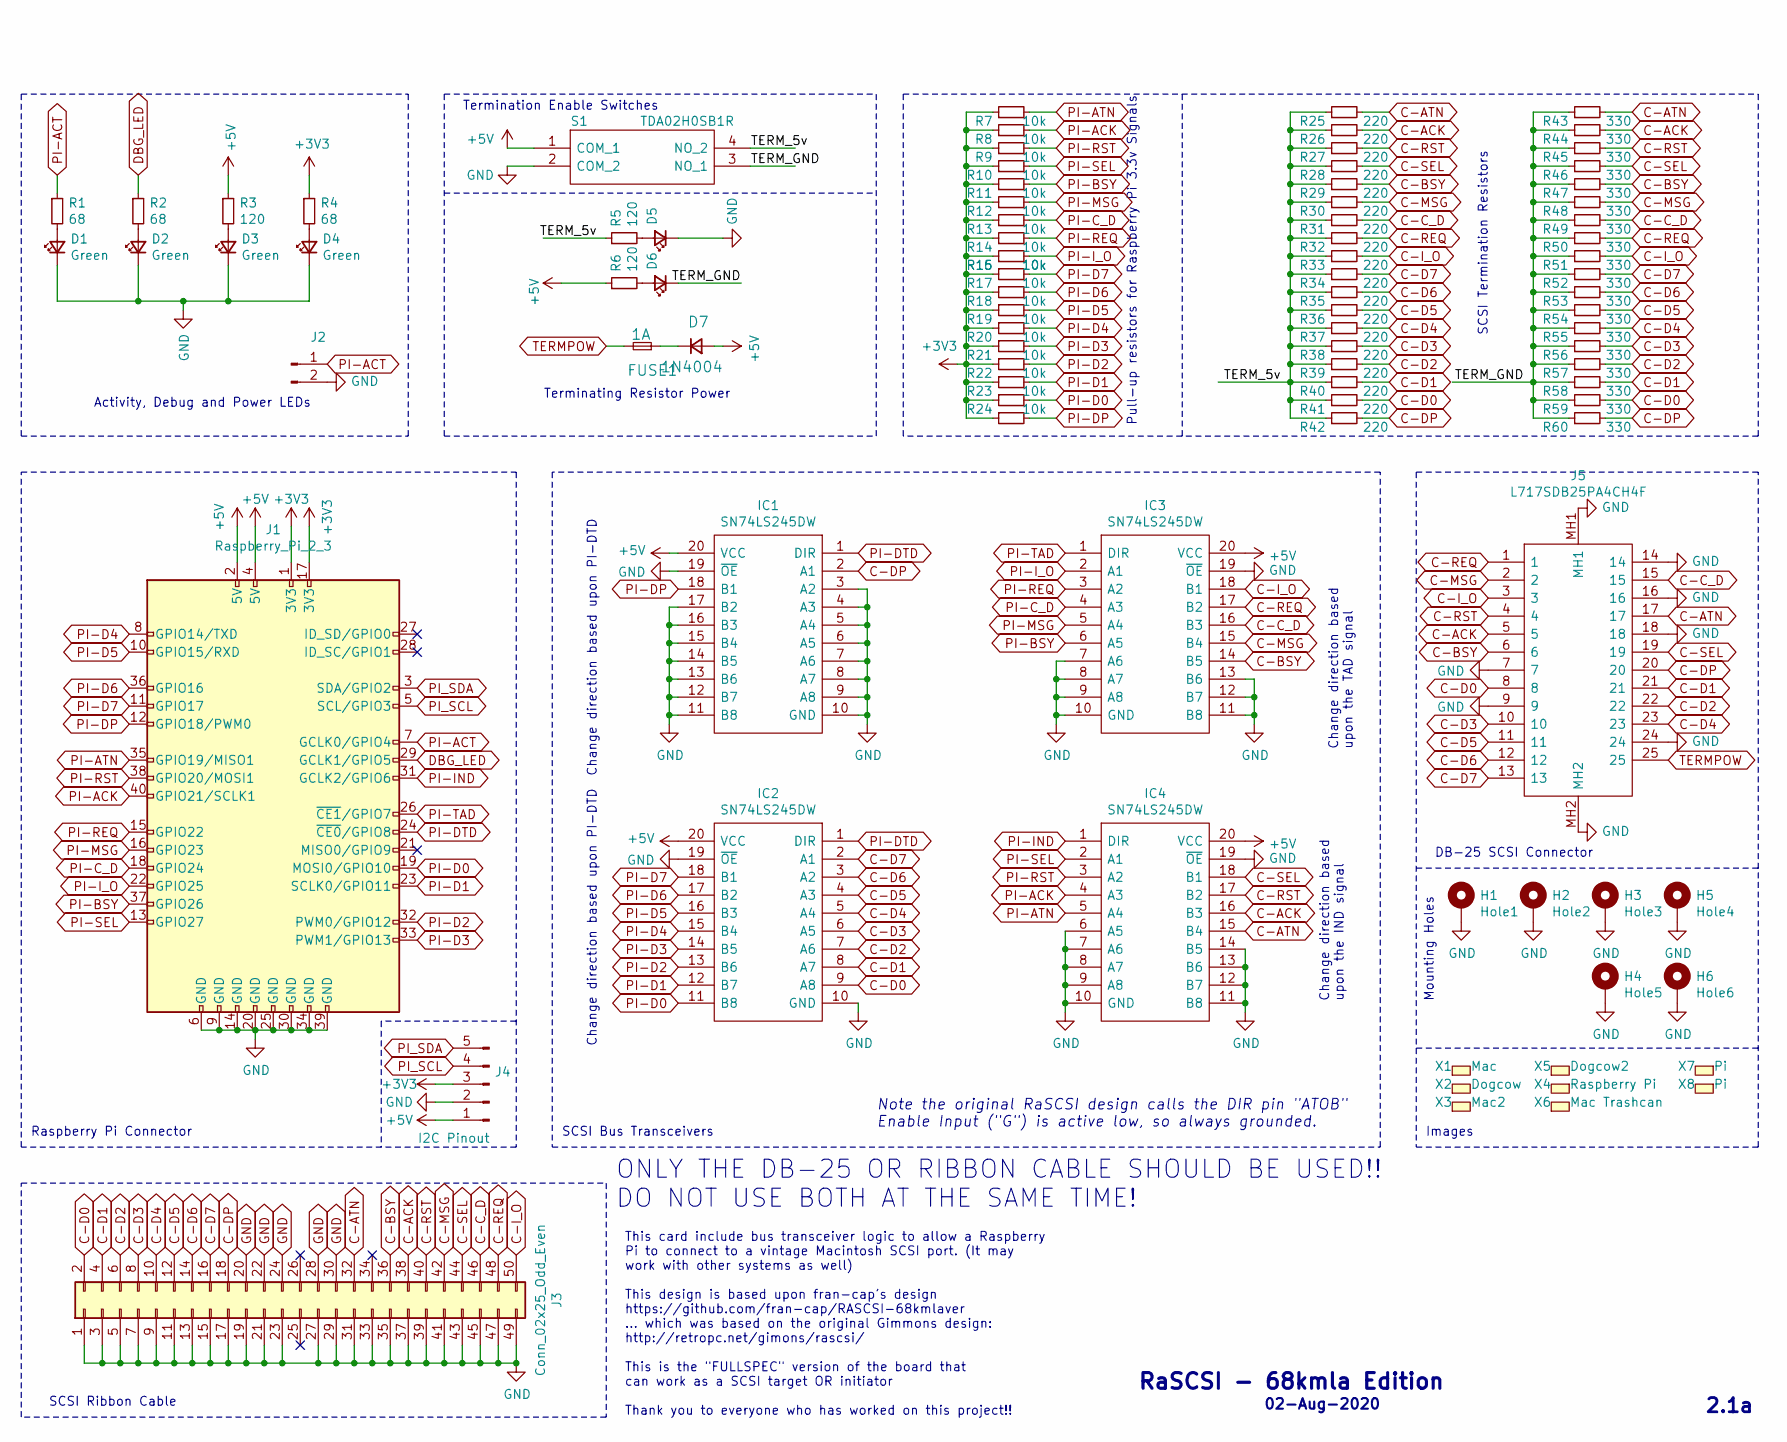
[picture p18: schematic rascsi_2p1.sch]

Parts:
D1, D2, D3, D4, D6: Green; LED_0805_2012Metric; LCSC C2297
D5: LED_Small; LED_0805_2012Metric; LCSC C2297
D7: 1N4004; D_SOD-123; LCSC C162734
FUSE1: 1A; Fuse_1206_3216Metric; LCSC C182974
H1: Hole1; MountingHole_2.7mm_M2.5_Pad_Via
H2: Hole2; MountingHole_2.7mm_M2.5_Pad_Via
H3: Hole3; MountingHole_2.7mm_M2.5_Pad_Via
H4: Hole5; MountingHole_2.7mm_M2.5_Pad_Via
H5: Hole4; MountingHole_2.7mm_M2.5_Pad_Via
H6: Hole6; MountingHole_2.7mm_M2.5_Pad_Via
IC1, IC2, IC3, IC4: SN74LS245DW; SOIC127P1030X265-20N; Mouser Part Number 595-SN74LS245DW
J1: Raspberry_Pi_2_3; PinSocket_2x20_P2.54mm_Vertical
J2: Conn_01x02_Male; PinHeader_1x02_P2.54mm_Vertical
J3: Conn_02x25_Odd_Even; PinHeader_2x25_P2.54mm_Vertical
J4: I2C Pinout; PinSocket_1x05_P2.54mm_Vertical
J5: L717SDB25PA4CH4F; Mouser Part Number 523-L717SDB25PA4CH4F
R1, R2, R4: 68; R_0402_1005Metric; LCSC C36871
R3, R5, R6: 120; R_0402_1005Metric; LCSC C25079
R7, R8, R9, R10, R11, R12, R13, R14, R15, R16, R17, R18, R19, R20, R21, R22, R23, R24: 10k; R_0402_1005Metric; LCSC C25744
R25, R26, R27, R28, R29, R30, R31, R32, R33, R34, R35, R36, R37, R38, R39, R40, R41, R42: 220; R_0402_1005Metric; LCSC C25091
R43, R44, R45, R46, R47, R48, R49, R50, R51, R52, R53, R54, R55, R56, R57, R58, R59, R60: 330; R_0402_1005Metric; LCSC C25104
S1: TDA02H0SB1R; SOIC127P812X230-4N; Mouser Part Number 611-TDA02H0SB1R
X1: Mac; mac_happy_small
X2: Dogcow; dogcow
X3: Mac2; mac_happy_small
X4: Raspberry Pi; pi_logo
X5: Dogcow2; dogcow
X6: Mac Trashcan; mac_trashcan
X7: Pi; pi_logo
X8: Pi; scsi_logo

Connections:
+3V3: J1.1 (3V3), J1.17 (3V3), J4.3, R4.1, R7.1, R8.1, R9.1, R10.1, R11.1, R12.1, R13.1, R14.1, R15.1, R16.1, R17.1, R18.1, R19.1, R20.1, R21.1, R22.1, R23.1, R24.1
+5V: D7.2 (A), IC1.20 (VCC), IC2.20 (VCC), IC3.20 (VCC), IC4.20 (VCC), J1.2 (5V), J1.4 (5V), J4.1, R3.1, R6.1, S1.1 (COM_1)
/TERM_5v: R5.1, R25.1, R26.1, R27.1, R28.1, R29.1, R30.1, R31.1, R32.1, R33.1, R34.1, R35.1, R36.1, R37.1, R38.1, R39.1, R40.1, R41.1, R42.1, S1.4 (NO_2)
/TERM_GND: D6.1 (K), R43.1, R44.1, R45.1, R46.1, R47.1, R48.1, R49.1, R50.1, R51.1, R52.1, R53.1, R54.1, R55.1, R56.1, R57.1, R58.1, R59.1, R60.1, S1.3 (NO_1)
C-ACK: IC4.16 (B3), J3.38, J5.5, R26.2, R44.2
C-ATN: IC4.15 (B4), J3.32, J5.17, R25.2, R43.2
C-BSY: IC3.14 (B5), J3.36, J5.6, R29.2, R47.2
C-C_D: IC3.16 (B3), J3.46, J5.15, R31.2, R49.2
C-D0: IC2.9 (A8), J3.2, J5.8, R41.2, R59.2
C-D1: IC2.8 (A7), J3.4, J5.21, R40.2, R58.2
C-D2: IC2.7 (A6), J3.6, J5.22, R39.2, R57.2
C-D3: IC2.6 (A5), J3.8, J5.10, R38.2, R56.2
C-D4: IC2.5 (A4), J3.10, J5.23, R37.2, R55.2
C-D5: IC2.4 (A3), J3.12, J5.11, R36.2, R54.2
C-D6: IC2.3 (A2), J3.14, J5.12, R35.2, R53.2
C-D7: IC2.2 (A1), J3.16, J5.13, R34.2, R52.2
C-DP: IC1.2 (A1), J3.18, J5.20, R42.2, R60.2
C-I_O: IC3.18 (B1), J3.50, J5.3, R33.2, R51.2
C-MSG: IC3.15 (B4), J3.42, J5.2, R30.2, R48.2
C-REQ: IC3.17 (B2), J3.48, J5.1, R32.2, R50.2
C-RST: IC4.17 (B2), J3.40, J5.4, R27.2, R45.2
C-SEL: IC4.18 (B1), J3.44, J5.19, R28.2, R46.2
DBG_LED: J1.29 (GCLK1/GPIO5), R2.1
GND: D1.1 (K), D2.1 (K), D3.1 (K), D4.1 (K), D5.1 (K), H1.1, H2.1, H3.1, H4.1, H5.1, H6.1, IC1.3 (A2), IC1.4 (A3), IC1.5 (A4), IC1.6 (A5), IC1.7 (A6), IC1.8 (A7), IC1.9 (A8), IC1.10 (GND), IC1.11 (B8), IC1.12 (B7), IC1.13 (B6), IC1.14 (B5), IC1.15 (B4), IC1.16 (B3), IC1.17 (B2), IC1.19 (~OE), IC2.10 (GND), IC2.19 (~OE), IC3.7 (A6), IC3.8 (A7), IC3.9 (A8), IC3.10 (GND), IC3.11 (B8), IC3.12 (B7), IC3.13 (B6), IC3.19 (~OE), IC4.6 (A5), IC4.7 (A6), IC4.8 (A7), IC4.9 (A8), IC4.10 (GND), IC4.11 (B8), IC4.12 (B7), IC4.13 (B6), IC4.14 (B5), IC4.19 (~OE), J1.6 (GND), J1.9 (GND), J1.14 (GND), J1.20 (GND), J1.25 (GND), J1.30 (GND), J1.34 (GND), J1.39 (GND), J2.2, J3.1, J3.3, J3.5, J3.7, J3.9, J3.11, J3.13, J3.15, J3.17, J3.19, J3.20, J3.21, J3.22, J3.23, J3.24, J3.27, J3.28, J3.29, J3.30, J3.31, J3.33, J3.35, J3.37, J3.39, J3.41, J3.43, J3.45, J3.47, J3.49, J4.2, J5.7, J5.9, J5.14, J5.16, J5.18, J5.24, J5.MH1, J5.MH2, S1.2 (COM_2)
unnamed: D1.2 (A), R1.2
unnamed: D2.2 (A), R2.2
unnamed: D3.2 (A), R3.2
unnamed: D4.2 (A), R4.2
unnamed: D5.2 (A), R5.2
unnamed: D6.2 (A), R6.2
unnamed: D7.1 (K), FUSE1.1
PI-ACK: IC4.4 (A3), J1.40 (GPIO21/SCLK1), R8.2
PI-ACT: J1.7 (GCLK0/GPIO4), J2.1, R1.1
PI-ATN: IC4.5 (A4), J1.35 (GPIO19/MISO1), R7.2
PI-BSY: IC3.6 (A5), J1.37 (GPIO26), R11.2
PI-C_D: IC3.4 (A3), J1.18 (GPIO24), R13.2
PI-D0: IC2.11 (B8), J1.19 (MOSI0/GPIO10), R23.2
PI-D1: IC2.12 (B7), J1.23 (SCLK0/GPIO11), R22.2
PI-D2: IC2.13 (B6), J1.32 (PWM0/GPIO12), R21.2
PI-D3: IC2.14 (B5), J1.33 (PWM1/GPIO13), R20.2
PI-D4: IC2.15 (B4), J1.8 (GPIO14/TXD), R19.2
PI-D5: IC2.16 (B3), J1.10 (GPIO15/RXD), R18.2
PI-D6: IC2.17 (B2), J1.36 (GPIO16), R17.2
PI-D7: IC2.18 (B1), J1.11 (GPIO17), R16.2
PI-DP: IC1.18 (B1), J1.12 (GPIO18/PWM0), R24.2
PI-DTD: IC1.1 (DIR), IC2.1 (DIR), J1.24 (~CE0~/GPIO8)
PI-IND: IC4.1 (DIR), J1.31 (GCLK2/GPIO6)
PI-I_O: IC3.2 (A1), J1.22 (GPIO25), R15.2
PI-MSG: IC3.5 (A4), J1.16 (GPIO23), R12.2
PI-REQ: IC3.3 (A2), J1.15 (GPIO22), R14.2
PI-RST: IC4.3 (A2), J1.38 (GPIO20/MOSI1), R9.2
PI-SEL: IC4.2 (A1), J1.13 (GPIO27), R10.2
PI-TAD: IC3.1 (DIR), J1.26 (~CE1~/GPIO7)
PI_SCL: J1.5 (SCL/GPIO3), J4.4
PI_SDA: J1.3 (SDA/GPIO2), J4.5
TERMPOW: FUSE1.2, J5.25

Notes on the sheet:
Note the original RaSCSI design calls the DIR pin "ATOB" Enable Input ("G") is active low, so always grounded.
Activity, Debug and Power LEDs
Pull-up resistors for Raspberry Pi 3.3v Signals
Raspberry Pi Connector
Terminating Resistor Power
SCSI Bus Transceivers
Change direction based upon PI-DTD
Change direction based upon the IND signal
Change direction based upon the TAD signal
DB-25 SCSI Connector
SCSI Ribbon Cable
ONLY THE DB-25 OR RIBBON CABLE SHOULD BE USED!! DO NOT USE BOTH AT THE SAME TIME!
This card include bus transceiver logic to allow a Raspberry Pi to connect to a vintage Macintosh SCSI port. (It may work with other systems as well) This design is based upon fran-cap's design https://github.com/fran-cap/RASCSI-68kmlaver ... which was based on the original Gimmons design: http://r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
Images
Mounting Holes
Termination Enable Switches
SCSI Termination Resistors
RaSCSI - 68kmla Edition
2.1a
02-Aug-2020

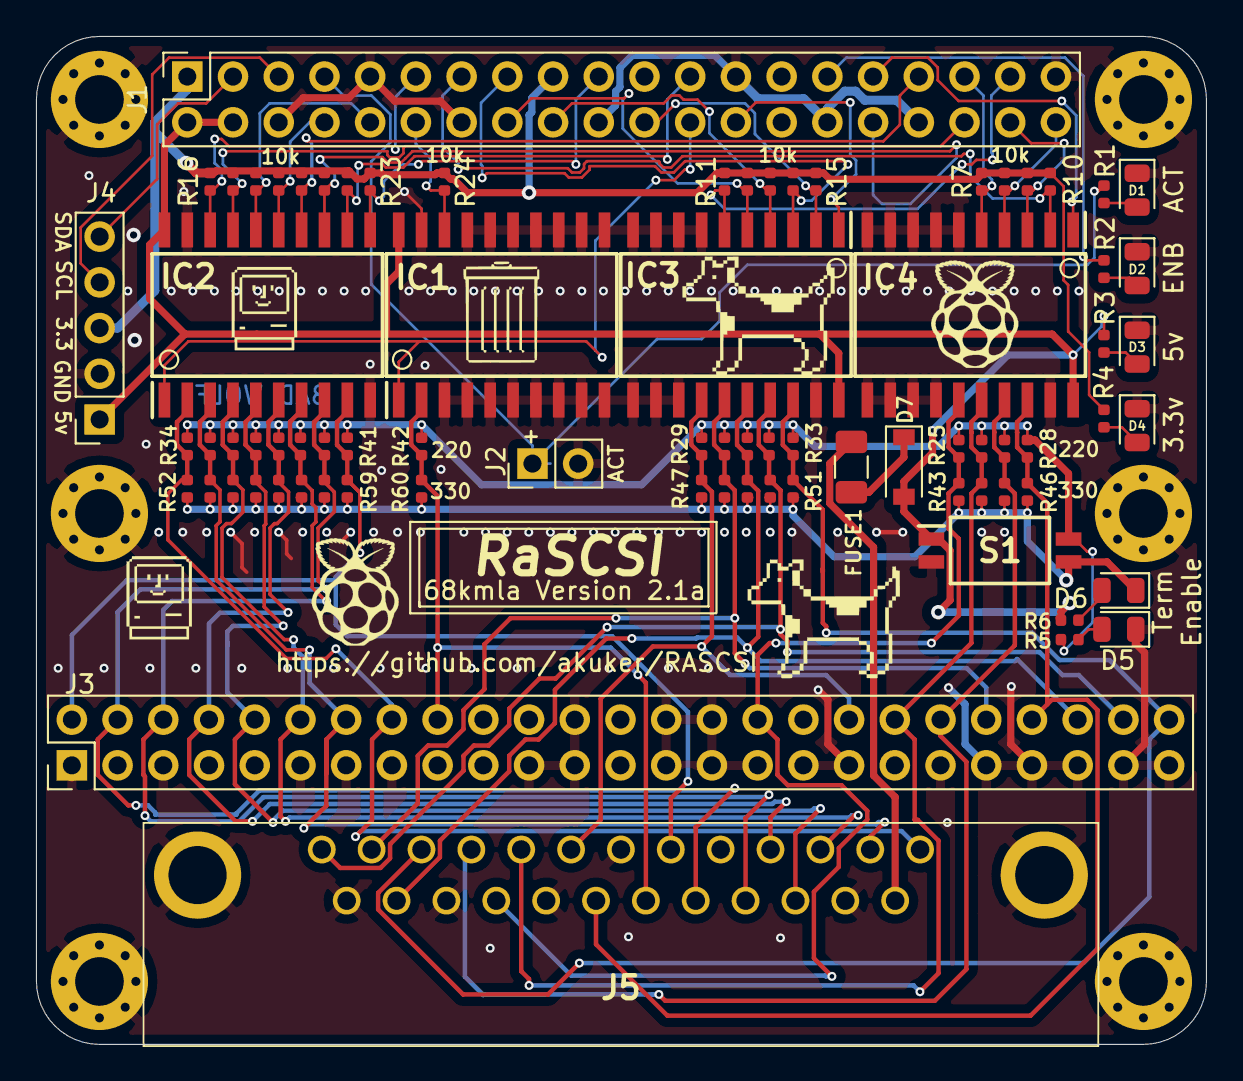
[picture p19: board rascsi_2p1.kicad_pcb from above]

Board: 2 copper layers, 65.0 x 56.0 mm, 91 parts (0 on the bottom side), 56 nets.
